anasluqman089/LonoMacro/BOM.csv

Component | Qty | Real Unit Price (USD) | Total Market Price (USD) | Reference Link
XIAO-nRF52840 (Standard) | 3 | 9.99 | 29.97 | https://www.aliexpress.com/w/wholesale-XIAO-nRF52840.html
Cherry MX Keyboard Switch | 4 | 0.60 | 2.40 | https://www.aliexpress.com/w/wholesale-Cherry-MX-keyboard-switch.html
1.3 Inch OLED Screen | 1 | 4.0 | 4.0 | https://www.aliexpress.com/w/wholesale-1.3-Inch-OLED-Screen.html
Rotary Encoder EC11 | 1 | 0.5 | 0.5 | https://www.aliexpress.com/w/wholesale-Rotary-Encoder.html
5mm LED | 3 | 0.1 | 0.3 | https://www.aliexpress.com/w/wholesale-5mm-LED.html
01x02 JST PH Connector | 3 | 0.15 | 0.45 | https://www.aliexpress.com/w/wholesale-01x02-JST-PH-Connector.html
220 Film Resistor | 3 | 0.05 | 0.15 | https://www.aliexpress.com/w/wholesale-220-Film-Resistor.html
6 mm THT Switch | 3 | 0.1 | 0.3 | https://www.aliexpress.com/w/wholesale-6-mm-THT-switch.html
01x04 Pin Header | 1 | 0.2 | 0.2 | https://www.aliexpress.com/w/wholesale-01x04-Pin-Header.html
PCB Fabrication (Custom Batch) | 1 | 12.0 | 12.0
3D Printed Case | 1 | 15.0 | 15.0
Estimated Real Total |  |  | 65.27
