anasluqman089/LonoMacro/CAD/Assembly.step

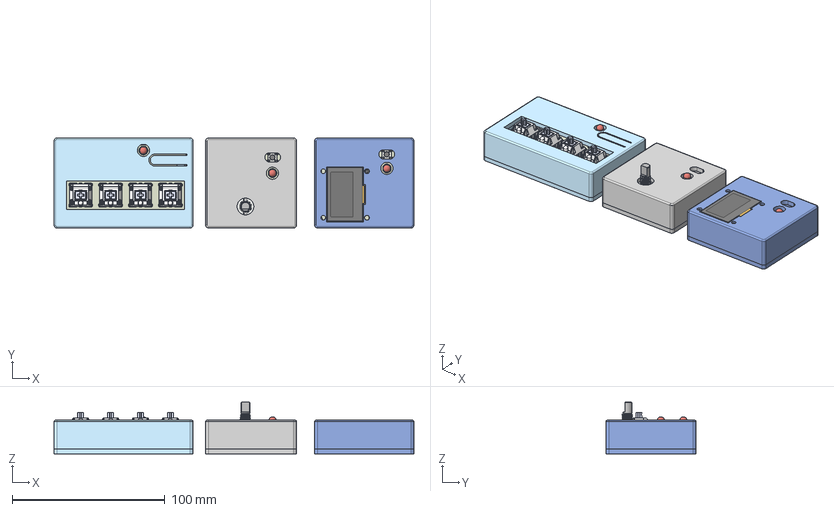
[picture p1: CAD file, 2026-11-01]
CAD/Assembly.step
235.5 x 59.0 x 33.7 mm
圆角5
Pulsador_2
BOSS-EXTRUDE7_3_
BOSS-EXTRUDE14_8__2
CAP_4 x 3
Silkscreen_1 x 13
R_Axial_DIN0207_L63mm_D25mm_P762mm_Horizontal_1
USR
BOSS-EXTRUDE14_9__1
Silkscreen x 13
Pin2
Pins x 4
CUT-EXTRUDE5_1
Pins_1 x 4
BOSS-EXTRUDE7_9__1
BOSS-EXTRUDE14_6_
LED x 4
BOSS-EXTRUDE14_12_
BOSS-EXTRUDE7_6_
Silkscreen_2 x 13
BOSS-EXTRUDE14_5__2
BOSS-EXTRUDE14_2__2
R_Axial_DIN0207_L63mm_D25mm_P762mm_Horizontal_2
BOSS-EXTRUDE14_6__2
BOSS-EXTRUDE7_7__2
Pin2_1
Pins_2 x 4
Pin2_3
Pin2_2
BOSS-EXTRUDE7_9__2
LED_D5.0mm_1
CAP 3_2 x 3
圆角2
BOSS-EXTRUDE7_9_
Led 3mm_trans_3 x 2
BOSS-EXTRUDE7_1__1
BOSS-EXTRUDE14_7__2
BOSS-EXTRUDE7_2_
BOSS-EXTRUDE7_1_
BOSS-EXTRUDE14_6__1
Pin1
Led 3mm_trans x 2
CAP_3 x 3
Bottom_3
CAP 3 x 3
BOSS-EXTRUDE14_9__2
USR_2
BOSS-EXTRUDE14_11_
CAP_2 x 3
Pin1_1
Led 3mm_trans_1 x 2
BOSS-EXTRUDE14_10_
BOSS-EXTRUDE7_2__2
BOSS-EXTRUDE14_4_
BOSS-EXTRUDE14_1__2
Pulsador_1
BOSS-EXTRUDE14_12__1
Shield_2
R_Axial_DIN0207_L63mm_D25mm_P762mm_Horizontal
BOSS-EXTRUDE14_3_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
