anasluqman089/LonoMacro/CAD/Part Studio 1.step

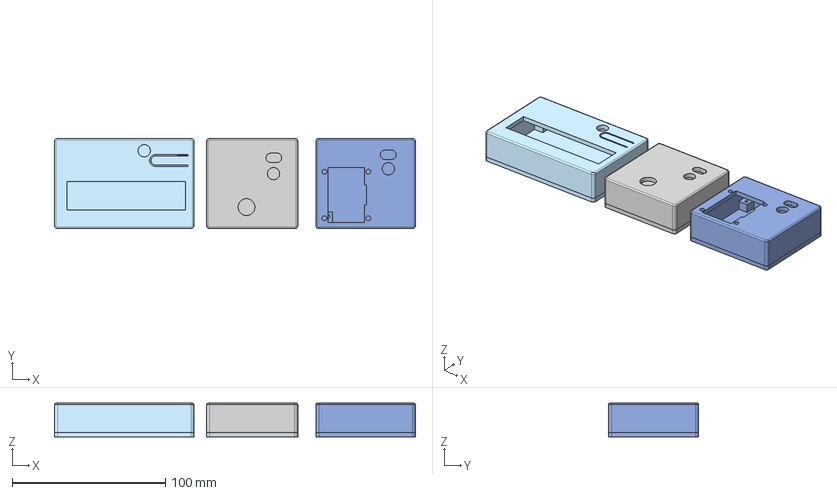
[picture p2: CAD file, 2026-11-01]
CAD/Part Studio 1.step
235.5 x 59.0 x 22.0 mm
