anasluqman089/LonoMacro/PCB/LonoMacro.step

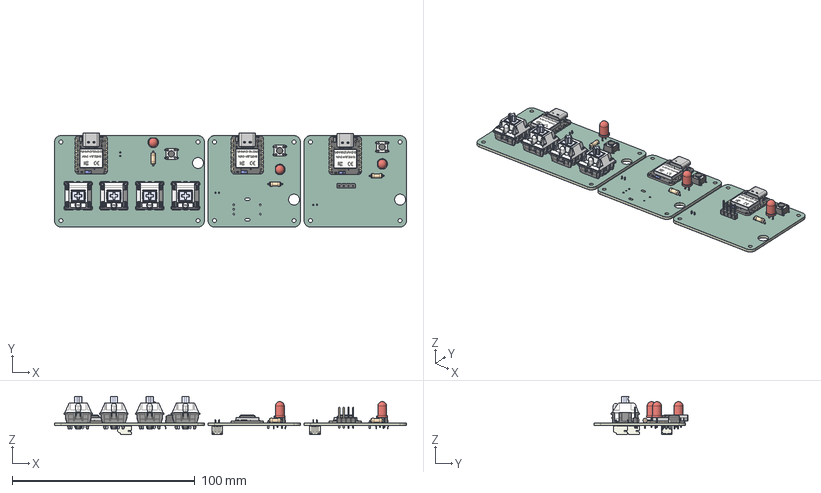
[picture p3: CAD file, 2026-11-01]
PCB/LonoMacro.step
192.5 x 51.4 x 21.0 mm
R_Axial_DIN0207_L63mm_D25mm_P762mm_Horizontal x 3
LED_D5.0mm x 3
SW_PUSH_6mm x 3
PinHeader_1x04_P254mm_Vertical
Bottom x 4
Pulsador x 4
Top x 4
Pieza5^Cherry MX x 4
Pin1 x 4
Pin2 x 4
Led 3mm_trans x 4
BOSS-EXTRUDE14_8_ x 3
BOSS-EXTRUDE7_4_ x 3
BOSS-EXTRUDE7_3_ x 3
BOSS-EXTRUDE14_4_ x 3
BOSS-EXTRUDE14_2_ x 3
BOSS-EXTRUDE14_11_ x 3
BOSS-EXTRUDE7_7_ x 3
BOSS-EXTRUDE14_9_ x 3
BOSS-EXTRUDE14_3_ x 3
BOSS-EXTRUDE14_7_ x 3
MIRROR2 x 3
BOSS-EXTRUDE14_5_ x 3
BOSS-EXTRUDE14_12_ x 3
BOSS-EXTRUDE7_8_ x 3
BOSS-EXTRUDE7_1_ x 3
BOSS-EXTRUDE14_10_ x 3
BOSS-EXTRUDE7_9_ x 3
BOSS-EXTRUDE14_6_ x 3
BOSS-EXTRUDE14_1_ x 3
BOSS-EXTRUDE7_6_ x 3
BOSS-EXTRUDE7_2_ x 3
CUT-EXTRUDE5 x 3
BOSS-EXTRUDE7_5_ x 3
Shield x 3
Pins x 3
CAP x 6
ANT1 x 3
Silkscreen x 3
CAP 3 x 3
LED x 3
USR x 3
MSM261D3526H1CPM x 3
JST_S2B_PH_K x 3
LonoMacro_soldermask x 2
LonoMacro_PCB_1
LonoMacro_PCB_2
LonoMacro_PCB_3
