anasluqman089/LonoMacro/Production/STL/Part Studio - Case.stl

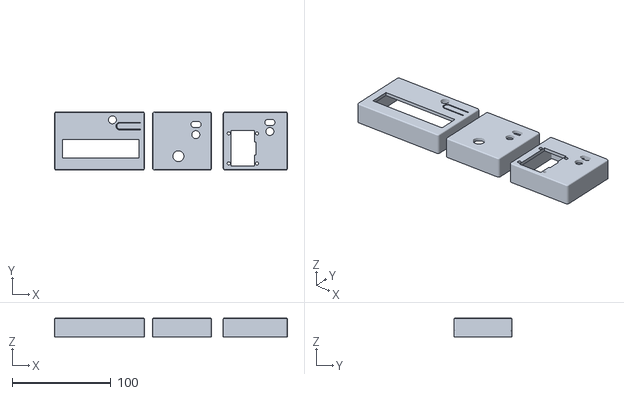
[picture p4: CAD file, 2026-11-01]
Production/STL/Part Studio - Case.stl
235.5 x 59.0 x 19.0
