anasluqman089/LonoMacro/Production/STL/Part Studio - Base.stl

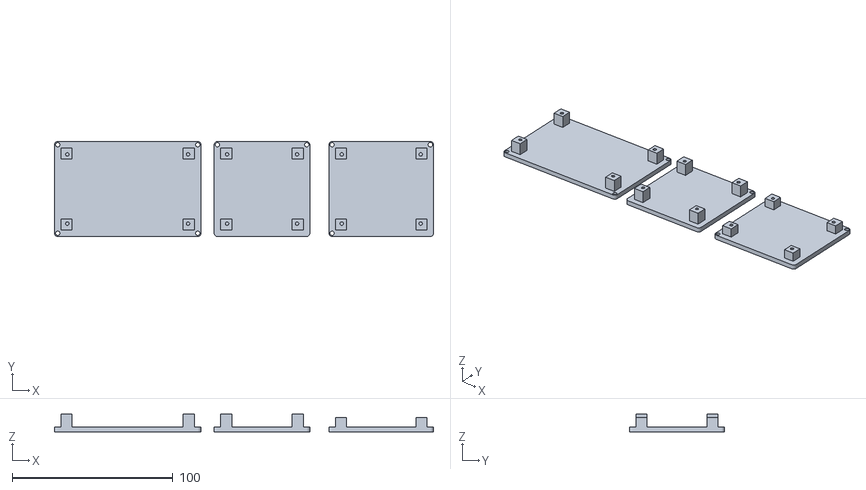
[picture p5: CAD file, 2026-11-01]
Production/STL/Part Studio - Base.stl
235.5 x 59.0 x 11.0
