anasluqman089/LonoMacro/PCB/LonoMacro.kicad_pcb

## KiCad design PCB/LonoMacro.kicad_pcb (2026-11-01)

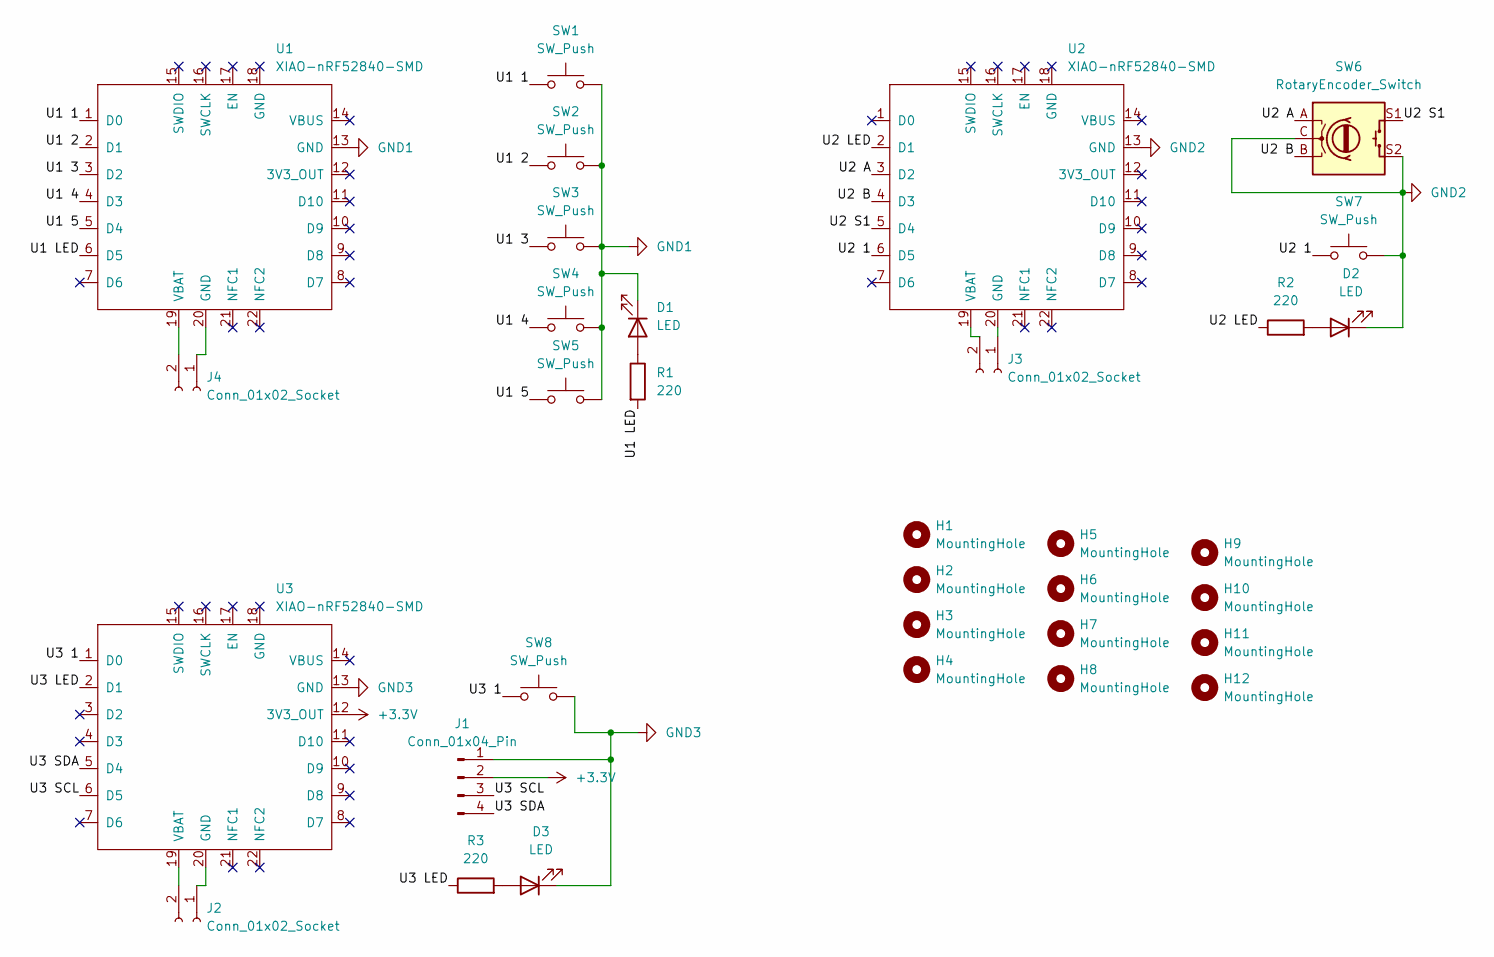
[picture p6: schematic LonoMacro.kicad_sch]

Parts:
D1, D2, D3: LED; LED_D5.0mm
H1, H2, H3, H4, H5, H6, H7, H8, H9, H10, H11, H12: MountingHole; MountingHole_2.2mm_M2
J1: Conn_01x04_Pin; PinHeader_1x04_P2.54mm_Vertical
J2, J3, J4: Conn_01x02_Socket; JST_PH_S2B-PH-K_1x02_P2.00mm_Horizontal
R1, R2, R3: 220; R_Axial_DIN0207_L6.3mm_D2.5mm_P7.62mm_Horizontal
SW1, SW2, SW3, SW4: SW_Push; SW_Cherry_MX_1.00u_PCB
SW5, SW7, SW8: SW_Push; SW_PUSH_6mm
SW6: RotaryEncoder_Switch; RotaryEncoder_Alps_EC11E-Switch_Vertical_H20mm
U1, U2, U3: XIAO-nRF52840-SMD

Connections:
+3.3V: J1.2, U3.12 (3V3_OUT)
/U1 1: SW1.1, U1.1 (D0)
/U1 2: SW2.1, U1.2 (D1)
/U1 3: SW3.1, U1.3 (D2)
/U1 4: SW4.1, U1.4 (D3)
/U1 5: SW5.1, U1.5 (D4)
/U1 LED: R1.2, U1.6 (D5)
/U2 1: SW7.1, U2.6 (D5)
/U2 A: SW6.A, U2.3 (D2)
/U2 B: SW6.B, U2.4 (D3)
/U2 LED: R2.1, U2.2 (D1)
/U2 S1: SW6.S1, U2.5 (D4)
/U3 1: SW8.1, U3.1 (D0)
/U3 LED: R3.1, U3.2 (D1)
/U3 SCL: J1.3, U3.6 (D5)
/U3 SDA: J1.4, U3.5 (D4)
GND1: D1.1 (K), SW1.2, SW2.2, SW3.2, SW4.2, SW5.2, U1.13 (GND)
GND2: D2.1 (K), SW6.C, SW6.S2, SW7.2, U2.13 (GND)
GND3: D3.1 (K), J1.1, SW8.2, U3.13 (GND)
unnamed: D1.2 (A), R1.1
unnamed: D2.2 (A), R2.2
unnamed: D3.2 (A), R3.2
unnamed: J2.1, U3.20 (GND)
unnamed: J2.2, U3.19 (VBAT)
unnamed: J3.1, U2.20 (GND)
unnamed: J3.2, U2.19 (VBAT)
unnamed: J4.1, U1.20 (GND)
unnamed: J4.2, U1.19 (VBAT)

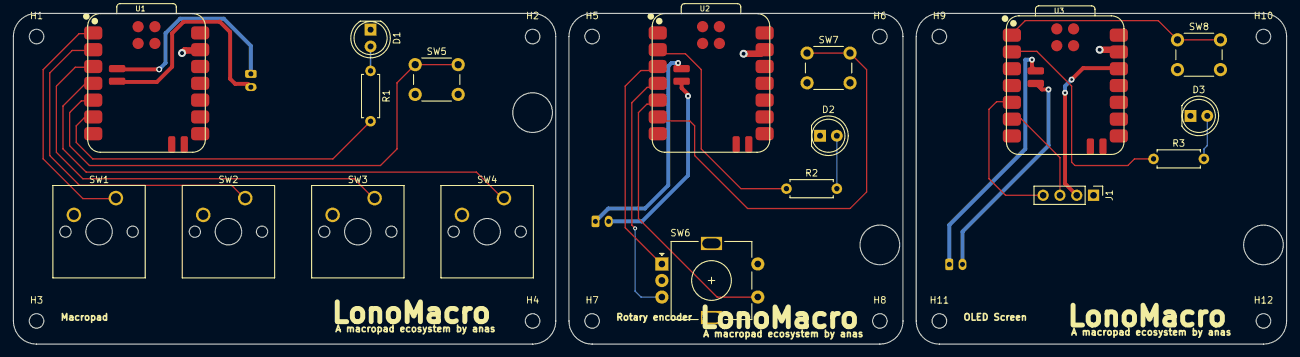
[picture p7: board LonoMacro.kicad_pcb from above]

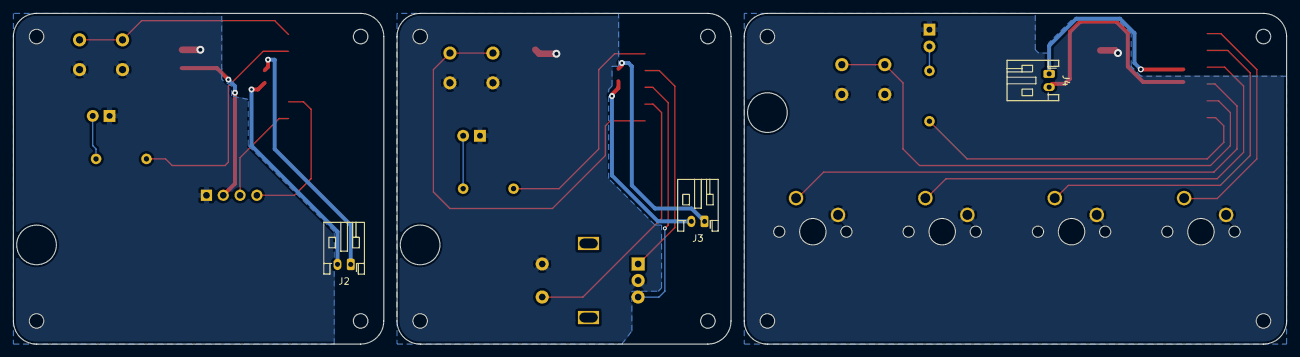
[picture p8: board LonoMacro.kicad_pcb from below]

Board: 2 copper layers, 192.5 x 50.0 mm, 33 parts (3 on the bottom side), 28 nets.
