anasluqman089/LonoMacro/(commit log)

2026-11-01 Add BLE-enabled Keypad, OLED Master, and Rotary Slave firmware
    - Implement Keypad Slave firmware with BLE service for key events.
    - Create OLED Master firmware to connect and display status of Keypad and Rotary devices.
    - Develop Rotary Slave firmware to handle rotary encoder input and communicate via BLE.
    - Introduce button debouncing and LED status indicators across all devices.
    - Ensure proper handling of BLE connections and events for seamless interaction.
    [Assembly.step, BOM.csv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]
2026-11-01 Revise BOM with updated components and prices
    Updated BOM.csv to reflect new component pricing and quantities.
    [BOM.csv]
